aa4cc/flying-ball-in-hoop/model/text/model_text.pdf

## Ball in double hoop: Derivation of a mathematical model

Martin Gurtner

1. MODELING

The system is cartooned in Fig. 1 and the modes of the hybrid description are displayed in Fig. 2. The hybrid description has three modes: the ball rolls on the outer hoop (S1), the ball is in free fall (S2), and the ball rolls on the inner hoop (S3).

Before we delve into the derivation of equations of motion for each mode, let us devote a few words to coordinate systems in which we will describe the motion of the ball. Due to the rotational symmetry, polar coordinates are a natural choice for modes S1 and S3. In contrast, Cartesian coordinates are more suitable for the free-fall mode (S2) because then the equations of motion are linear. In fact, it turns out that the description of motion in S2 in polar coordinates is strongly nonlinear. Thus, from the implementation point of view (i.e. to increase numerical stability), one should use polar coordinates for modes S1 and S3 and Cartesian coordinates for S2. Nevertheless, transformations of the coordinates would make equations in this paper unnecessarily complicated, and thus we stick to polar coordinates for all three modes.

For simplicity, we will not state the time dependence explicitly. At first, we derive equations of motion for each mode and after that, we describe guards and reset maps for transitions between the modes.

1.1 Outer hoop (S1)

A model of a ball rolling in a hoop was derived by ?. For reader’s convenience—and because Wellstead made a small mistake in the derivation of the model—we rederive the model.

We use Euler-Lagrange equation to derive the model. Let us choose angles ψ and θ (see Fig. 1) as the generalized co-

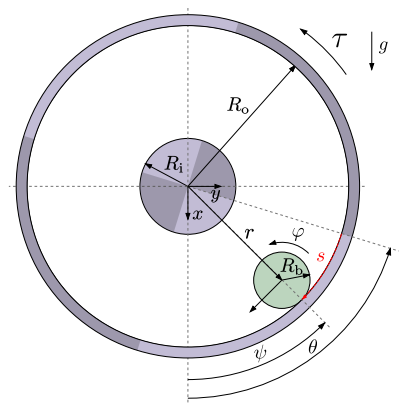
[picture p7: figure]

Fig. 1. A sketch of the ball and hoop system.

ordinates. We assume that the ball rolls without slipping. In addition, we assume that we can directly command the torque τ acting on the hoop.

The kinetic co-energy of the ball is

T

∗ =

1
2

mv² +

1
2

Ib( ˙ϕ + ˙θ)
2 +

1
2

Ih

˙θ
2
, | (1)

where m is the mass of the ball, Ib is the moment of inertia of the ball, Ih is the moment of inertia of the hoop and ϕ =

s
Rb

=

Ro
Rb

(θ − ψ). The translational velocity v and the angular velocity ˙ϕ of the ball can be expressed as follows
v = − (Ro − Rb) ψ,˙ | (2a)

ϕ˙ =

Ro
Rb
˙θ − ψ˙
. | (2b)

Thus, the kinetic energy expressed in the generalized coordinates is

T

∗ =

1
2

m (Ro − Rb)

2
ψ˙²+

1
2

Ib

Ro + Rb
Rb

˙θ −

Ro
Rb

ψ˙

2
| +
| 1
| 2 Ih

˙θ
2
(3)
Potential energy of the system is given by the potential energy of the ball and that is by
V = −mg (Ro − Rb) cos ψ | (4)

and the system content modeling friction of the ball and hoop is

D =

1
2

bbϕ˙

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
˙θ − ψ˙

2
+

1
2

bh

˙θ
2
. (5)

Defining the Lagrangian L = T

∗ − V , an equations of
motion of the hoop and the ball, respectively, can be computed by Euler-Lagrange equation as
d
dt
∂L
∂ ˙θ
−

∂L
∂θ +

∂D
∂ ˙θ
= τ | (6)

d
dt
∂L
∂ψ˙
−

∂L
∂ψ +

∂D
∂ψ˙
= 0 | (7)

which results in the following differential equation a¯oψ¨ + ¯boψ˙ + ¯co sin ψ + ¯do

˙θ = ¯eo

¨θ, | (8)

with coefficients

Outer hoop | Free fall | Inner hoop
S1 | S2 | S3

γ1 > 0

γ2 > 0

γ3 > 0

γ4 > 0

Fig. 2. Modes of the hybrid description of the ball and hoop system.

Fig. 3. A sketch of the ball rolling on the inner hoop.

a¯o = m (Ro − Rb)

2 + I

R²
o
R²
b
, | (9a)

¯bo = b

R²
o
R²
b
, | (9b)
c¯o = mg (Ro − Rb), | (9c)
¯do = −¯bo, | (9d)

e¯o = I

Ro
Rb
Ro
Rb

+ 1
. | (9e)

1.2 Free fall (S2)

The motion of the center of the ball in free fall can be easily described in Cartesian coordinates because the only force acting on the ball is the gravitational force. Considering the Cartesian coordinate system shown in Fig. 1, we have

x¨ = g | and | ¨y = 0. | (10)

In order to get equations of motion in polar coordinates (r, ψ) (see Fig. 1), we only need to transform the coordinates by relations x = r cos ψ and y = r sin ψ. This way, we get

r¨ = rψ˙² + g cos ψ, | (11a)

ψ¨ = −

1
r
g sin ψ + 2ψ˙r˙
| | . | (11b)

To fully describe the state of the system during free fall of the ball we also need to describe evolution of ϕ; we assume that the angular velocity ˙ϕ is constant during the free fall.

1.3 Inner hoop (S3)

A sketch of the ball rolling on the inner hoop is shown in Fig. 3. The equations of motion for the ball rolling on the inner hoop can be derived along similar lines as for the ball on the outer hoop. The only difference is that the effective rolling radius is Ri + Rb instead of Ro − Rb and angle ϕ has the opposite orientation. Therefore, we skip the derivation and state directly the resulting equations of motion:
a¯iψ¨ + ¯biψ˙ + ¯ci sin ψ + ¯di

˙θ = ¯ei

¨θ, | (12)

where

a¯i = m (Ri + Rb)

2 + I

R²
i
R²
b
, | (13a)

¯bi = b

R²
i
R²
b
, | (13b)
c¯i = mg (Ri + Rb), | (13c)
¯di = −¯bi
, | (13d)

e¯i = I

Ri
Rb
Ri
Rb

− 1

. | (13e)

1.4 Transition between modes

Transition from S1 to S2 Mode S1 (outer hoop) is valid as long as the centripetal force Fc acting on the ball is larger then the normal component of the gravitational force Fg with respect to the hoop. Mathematically, it is valid if
Fg cos ψ + Fc = mg cos ψ + m (Ro − Rb) ψ˙² > 0. (14)

If this condition does not hold, the ball drops of the hoop. It readily follows from (14) that the guard for transition from S1 to S2 is
γ1 = −g cos ψ − (Ro − Rb) ψ˙² > 0. | (15)

The reset map for states r, ˙r, ϕ and ˙ϕ is r

+ = Ro − Rb, | (16a)

r˙

+ = 0, | (16b)

ϕ

+ = (θ

− − ψ

−)

Ro
Rb
, | (16c)

ϕ˙

+ =

Ro + Rb
Rb

˙θ −

Ro
Rb
ψ.˙ | (16d)

The first three relations are apparent. The last one is derived from the inertial angular velocity ( ˙ϕ

− + ˙θ
−) of the
ball and (2b). The remaining states transit to the mode S2 without any change, that is θ

+ = θ

−,

˙θ

+ = ˙θ
−, ψ
+ = ψ

−
and ψ˙+ = ψ˙−.

Transition from S2 to S1 This transition occurs when the ball hits the outer hoop. Thus the guard is
γ2 = r − Ro + Rb > 0 | (17)
and the corresponding reset map for ψ˙
is
ψ˙⁺ = ψ˙⁻ + ψ˙⁻
rot | (18)
where ψ˙⁻
rot is derived from the angular velocity of the ball ϕ˙

− and can be computed from (2b):

ψ˙⁻
rot = ˙θ
− −

Rb
Ro

ϕ˙

−. | (19)

The remaining states transit unchanged, that is θ

+ = θ

−,
˙θ

+ = ˙θ
− and ψ
+ = ψ

−.

Transition from S2 to S3 Analogously to the previous case, the transit occurs when the ball hits the inner hoop and the guard is
γ3 = Ri + Rb − r > 0. | (20)
The reset map is also almost the same; the only difference is that the angular velocity ψ˙⁻
rot here is computed as follows

ψ˙⁻

rot = ˙θ
− +

Rb
Ri

ϕ˙

−. | (21)

Transition from S3 to S2 Similarly to the transition from the outer hoop to free fall, the transition from the inner hoop to free fall occurs when the centripetal force becomes larger then the normal component of the gravitational force with respect to the hoop, that is
γ4 = g cos ψ + (Ri + Rb) ψ˙² > 0.

and analogously to (16), the reset map is
r
+ = Ri + Rb, | (22a)

r˙

+ = 0, | (22b)

ϕ

+ = −(θ

− − ψ

−)

Ri
Rb
, | (22c)

ϕ˙

+ = −

Ri − Rb
Rb

˙θ −

Ri
Rb

ψ˙

, | (22d)

with the remaining states θ,

˙θ, ψ and ψ˙ transiting unchanged.

min
u(t),x(t),Tf

# Z Tf

0

u

2
(t)dt | (23)

subject to: x(0) = x0
x(Tf) = xf
0 < Tf < Tmax
g (x(t)) < 0
|u(t)| ≤ umax
x˙(t) = f(x(t), u(t))

x

∗

(t), u∗
(t) (24)

A(t) = ∂f (x(t), u(t))
∂x
x(t)=x∗(t),u(t)=u∗(t)

(25)

B(t) = ∂f (x(t), u(t))
∂u
x(t)=x∗(t),u(t)=u∗(t)

(26)

δx = x − x

∗
, δu = u − u

∗
