aa4cc/flying-ball-in-hoop/model/text/figs/asd.pdf

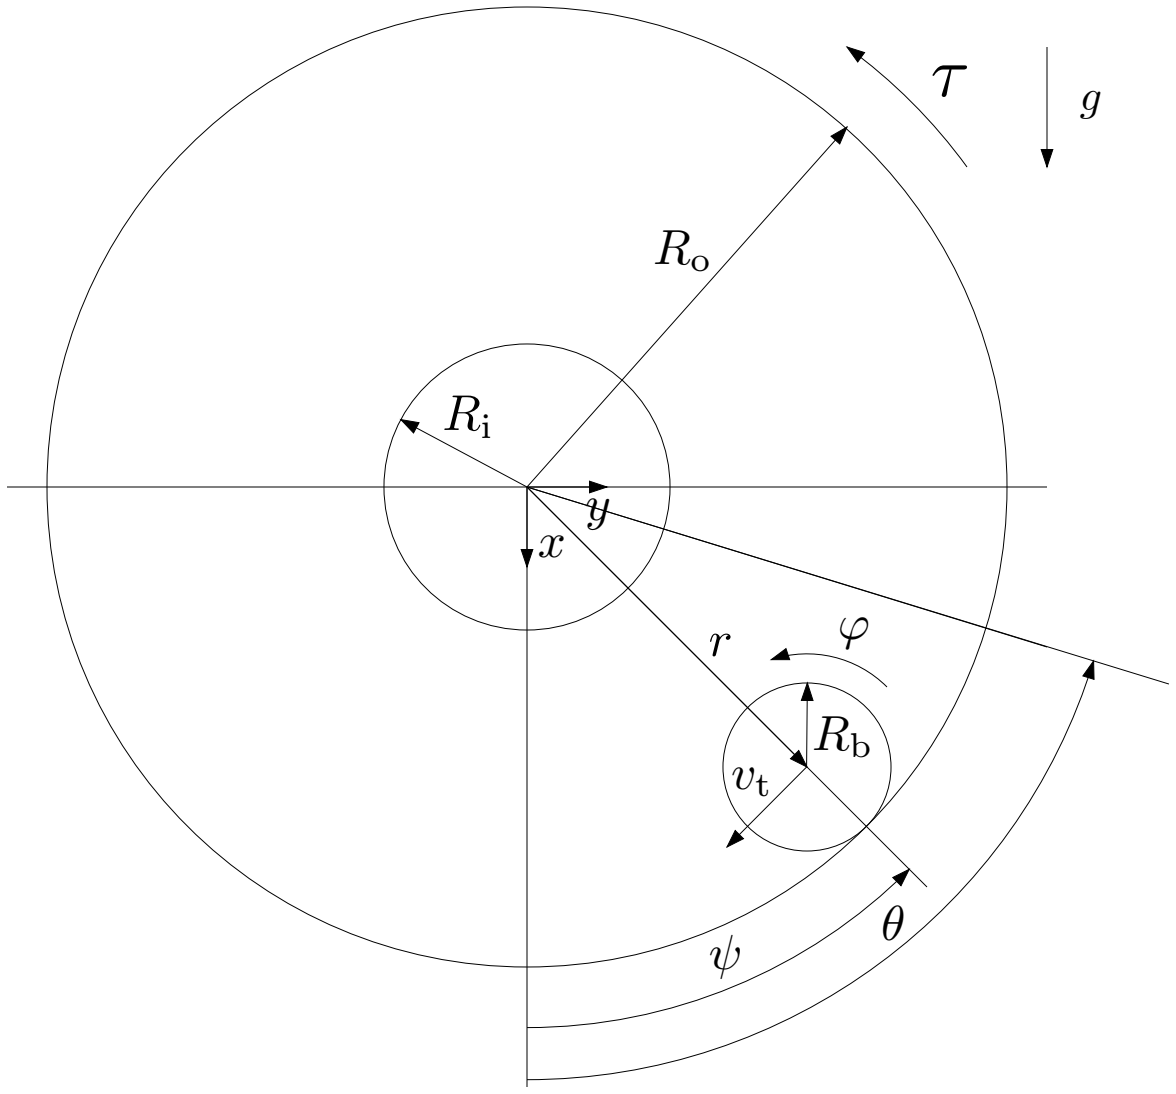
[picture p8: figure]
