aa4cc/flying-ball-in-hoop/cad/hoop/dimensionDescription.jpg

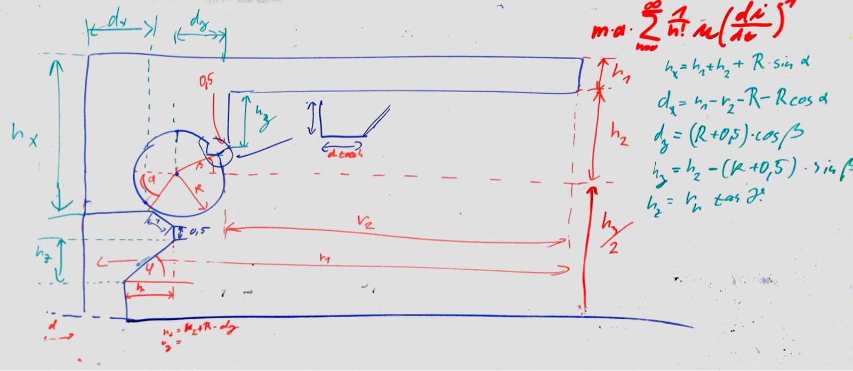
cad/hoop/dimensionDescription.jpg
