aa4cc/flying-ball-in-hoop/docs/img/BoxBack.jpg

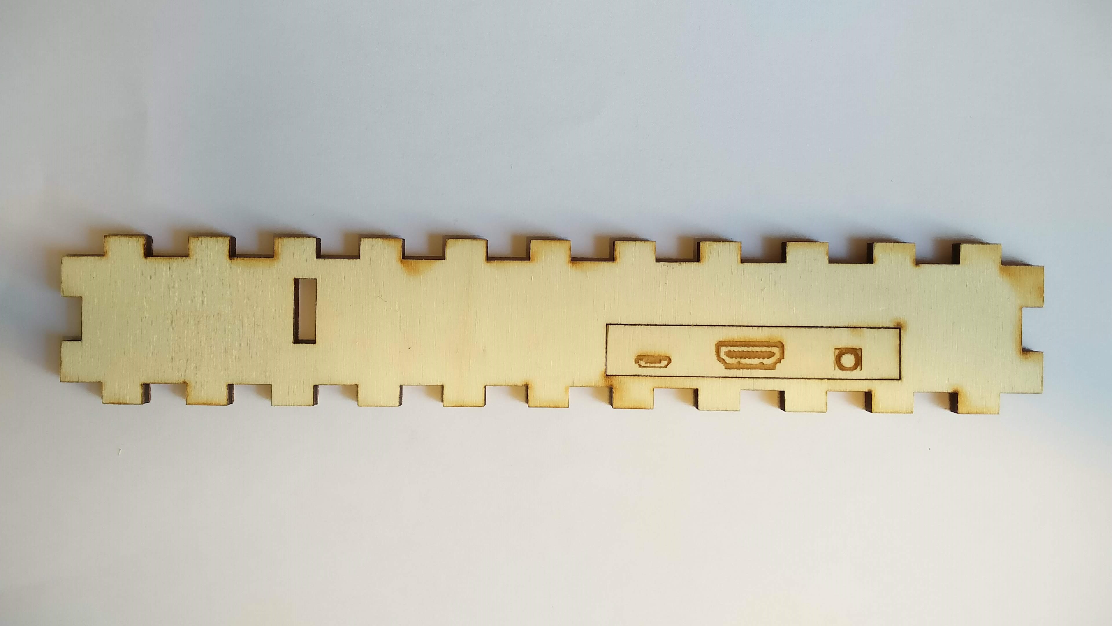
docs/img/BoxBack.jpg
