aa4cc/flying-ball-in-hoop/docs/img/BoxClosedHolder.jpg

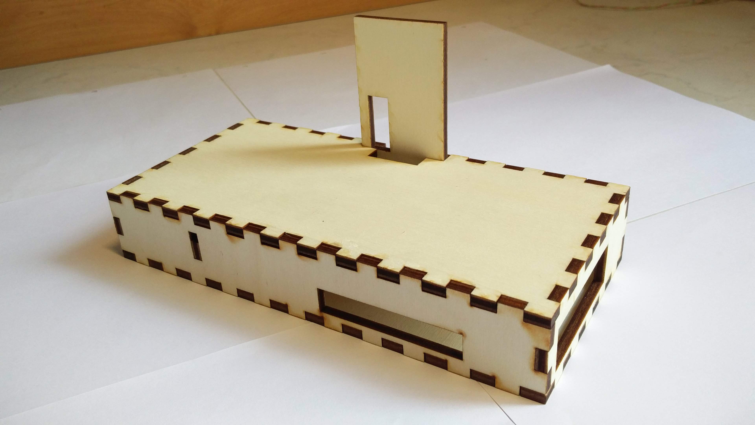
docs/img/BoxClosedHolder.jpg
