aa4cc/flying-ball-in-hoop/docs/img/BoxFront1.jpg

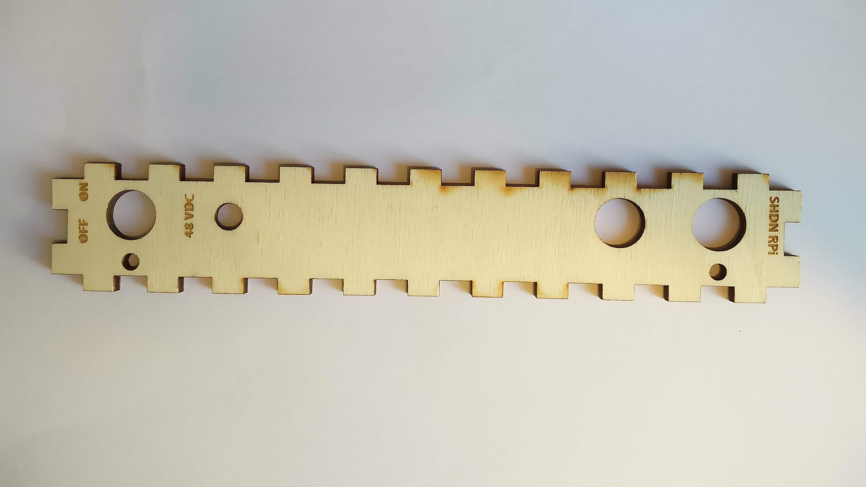
docs/img/BoxFront1.jpg
