aa4cc/flying-ball-in-hoop/docs/img/BoxOpenHolder.jpg

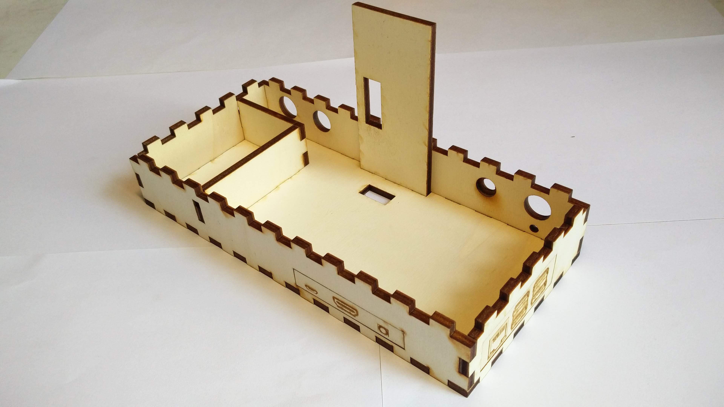
docs/img/BoxOpenHolder.jpg
