aa4cc/flying-ball-in-hoop/m/identification/Copy_of_exp03_prbs/led.png

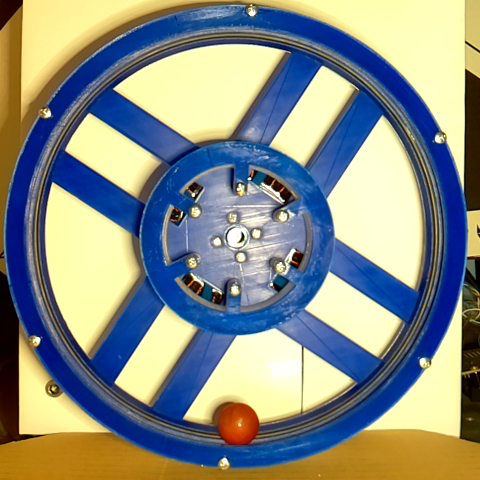
m/identification/Copy_of_exp03_prbs/led.png
