aa4cc/flying-ball-in-hoop/m/identification/Copy_of_exp03_prbs/meas_pos01.png

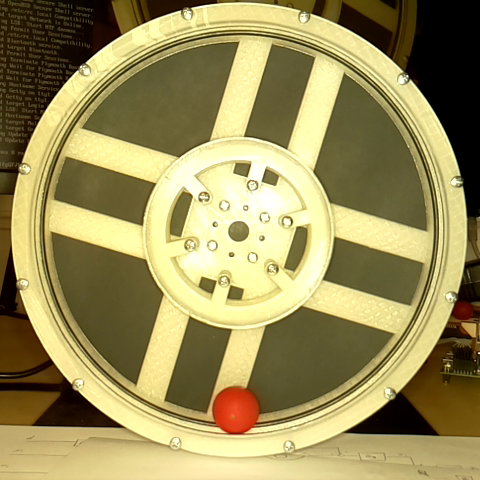
m/identification/Copy_of_exp03_prbs/meas_pos01.png
