aa4cc/flying-ball-in-hoop/m/identification/exp01/meas_pos01.png

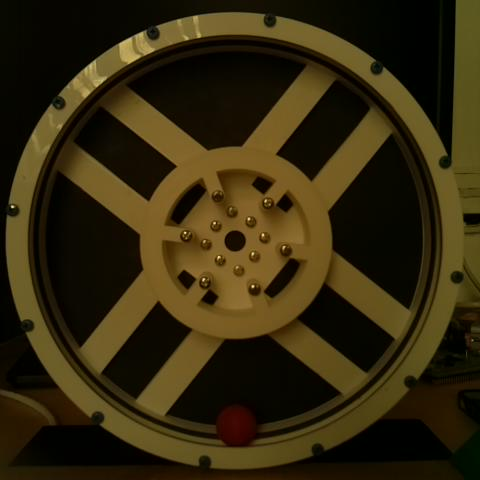
m/identification/exp01/meas_pos01.png
