aa4cc/flying-ball-in-hoop/m/identification/exp02_prbs/meas_pos01.png

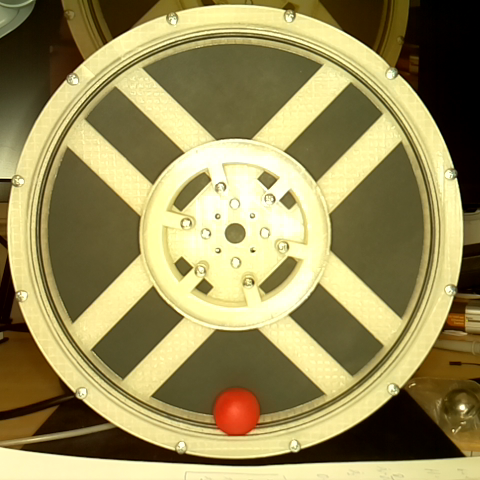
m/identification/exp02_prbs/meas_pos01.png
