aa4cc/flying-ball-in-hoop/docs/img/LaserCutter/Front2.dxf

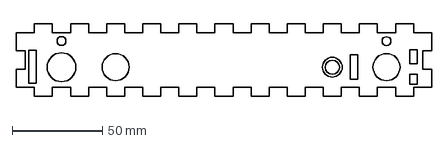
[picture p18: CAD file, 2019-02-22]
docs/img/LaserCutter/Front2.dxf
230.0 x 40.0 mm
