aa4cc/flying-ball-in-hoop/docs/img/LaserCutter/Front.dxf

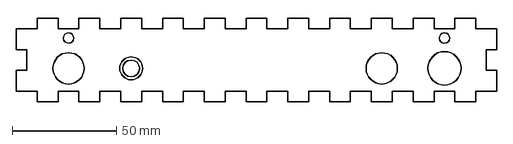
[picture p19: CAD file, 2019-02-22]
docs/img/LaserCutter/Front.dxf
230.0 x 40.0 mm
