aa4cc/flying-ball-in-hoop/docs/img/LaserCutter/Holder.dxf

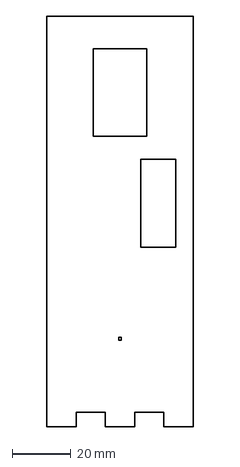
[picture p20: CAD file, 2019-02-22]
docs/img/LaserCutter/Holder.dxf
50.0 x 140.0 mm
