aa4cc/flying-ball-in-hoop/docs/img/LaserCutter/Inner2.dxf

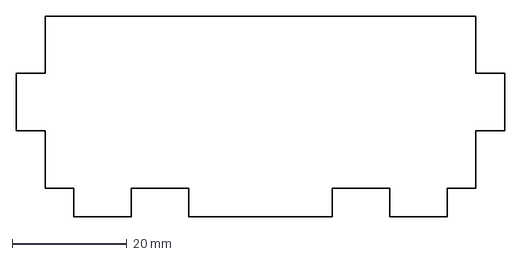
[picture p21: CAD file, 2019-02-22]
docs/img/LaserCutter/Inner2.dxf
85.0 x 35.0 mm
