aa4cc/flying-ball-in-hoop/docs/img/LaserCutter/Top2.dxf

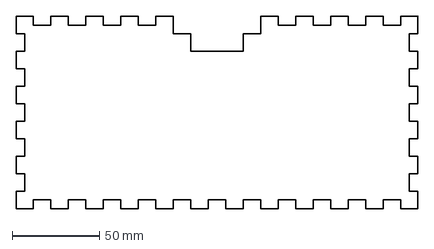
[picture p22: CAD file, 2019-02-22]
docs/img/LaserCutter/Top2.dxf
230.0 x 110.0 mm
