aa4cc/flying-ball-in-hoop/docs/img/LaserCutter/Back.dxf

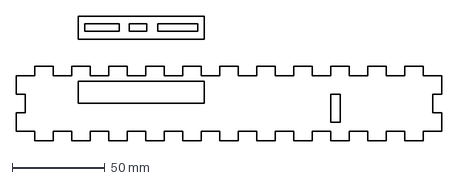
[picture p23: CAD file, 2019-02-22]
docs/img/LaserCutter/Back.dxf
230.0 x 67.0 mm
