aa4cc/flying-ball-in-hoop/docs/img/LaserCutter/Inner1.dxf

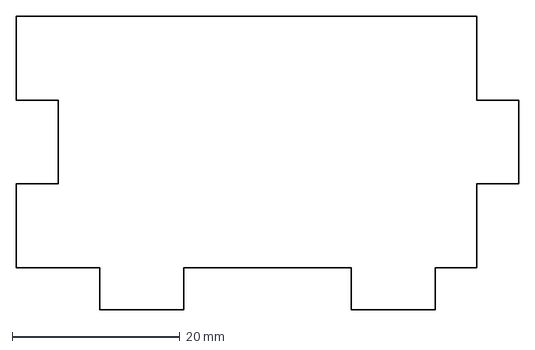
[picture p24: CAD file, 2019-02-22]
docs/img/LaserCutter/Inner1.dxf
60.0 x 35.0 mm
