aa4cc/flying-ball-in-hoop/docs/img/LaserCutter/Bot.dxf

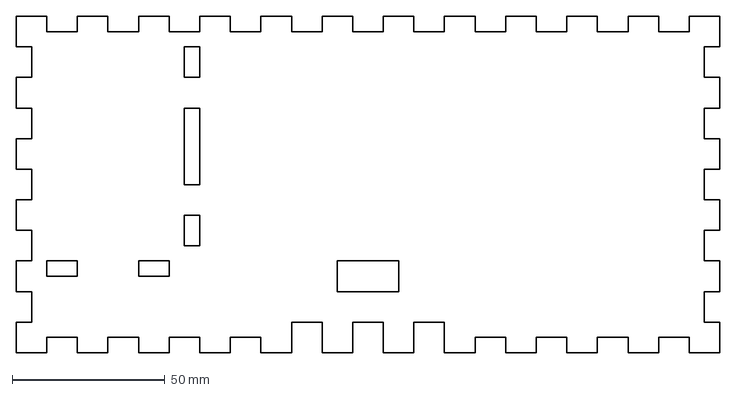
[picture p25: CAD file, 2019-02-22]
docs/img/LaserCutter/Bot.dxf
230.0 x 110.0 mm
