aa4cc/flying-ball-in-hoop/docs/img/LaserCutter/RightSide.dxf

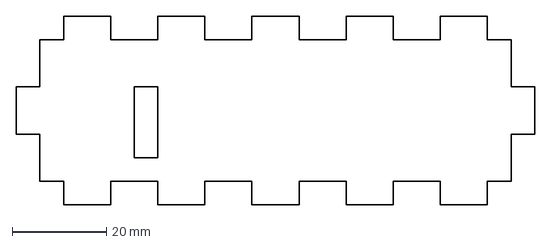
[picture p26: CAD file, 2019-02-22]
docs/img/LaserCutter/RightSide.dxf
110.0 x 40.0 mm
