aa4cc/flying-ball-in-hoop/docs/img/LaserCutter/LeftSide.dxf

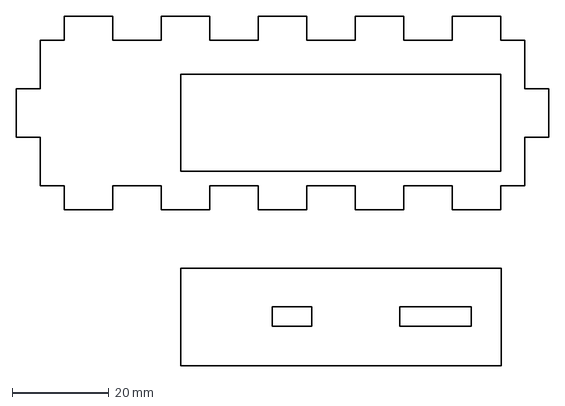
[picture p27: CAD file, 2019-02-22]
docs/img/LaserCutter/LeftSide.dxf
110.0 x 72.2 mm
