aa4cc/flying-ball-in-hoop/docs/img/LaserCutter/backBlackSheet.dxf

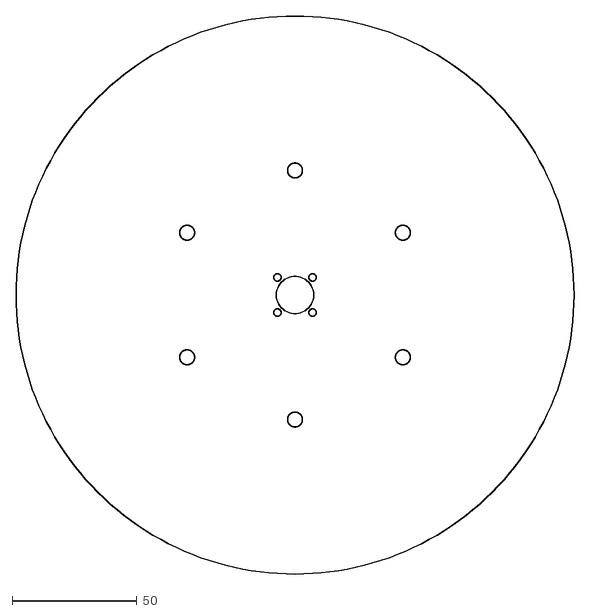
[picture p28: CAD file, 2018-10-05]
docs/img/LaserCutter/backBlackSheet.dxf
224.0 x 224.0
