aa4cc/flying-ball-in-hoop/(list of files, cad)

Other CAD files:
cad/lampHeatSink/lampHeatSink.dwg
cad/raspiHolder/raspiHolder.dwg
cad/lampHeatSink/light_diffuser.dwg
cad/hoop/data-access.scad
cad/hoop/data-metric_cyl_head_bolts.scad
cad/hoop/materials.scad
