aa4cc/flying-ball-in-hoop/docs/buildingInstructions_HW.md

---
layout: page
title: Hardware assembly
subtitle: A step-by-step photoguide
---
<!--
# Ball in Hoop

## Introduction -->

The assembly guide is divided into several steps. At first, we will make the light, then we will make the box. Then we will attach it to the acrylics. Successively, we print the motor holder and the hoop in 3D printer, mount the holder to the board, attach the motor, encoder and ODrive to the holder and finally mount the hoop to the motor. Then we will wire all things together and move to the software.

# 1. Light

Please visit <https://github.com/aa4cc/raspicam-lamp>

We actually realized that we are not satisfied with the concept of the light (see _Future development_) and decided to solder several things differently from what we previously intended. Details are provided in the next picture:

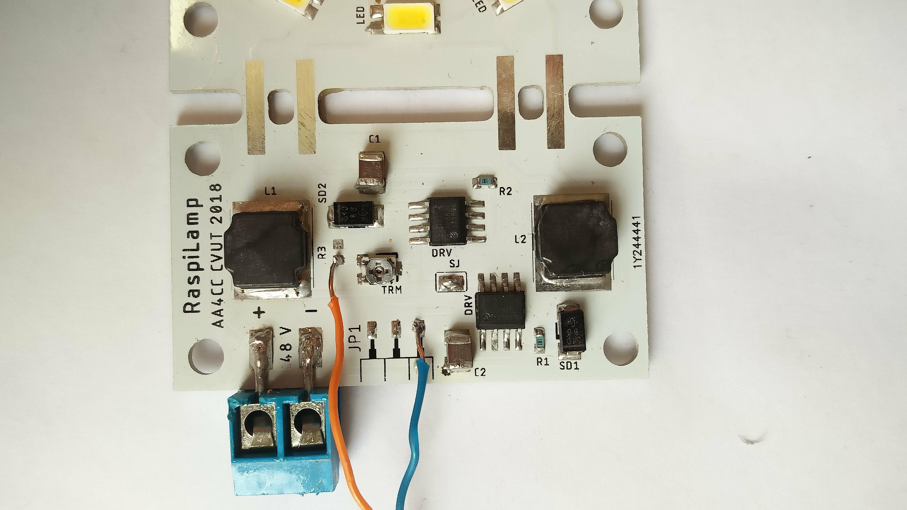
[picture p29: docs/img/LightCtrl.jpg]
LightCtrl


This means that we used the trimmer to lessen the voltage coming from RPi (3.3V) to a voltage convenient for the AP8801 chip (cca 1.25V) and we control both LED branches simultaneously, because solder jumper is soldered.

# 2. Box

Box is glued together according to following pictures:

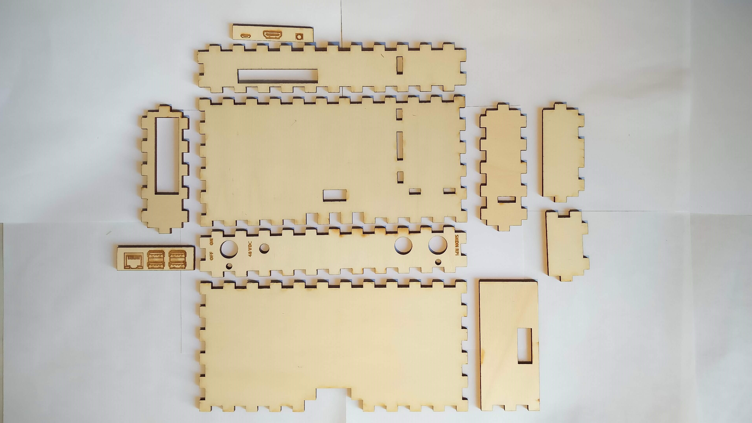
[picture p30: docs/img/BoxInPlane.jpg]
BoxInPlane


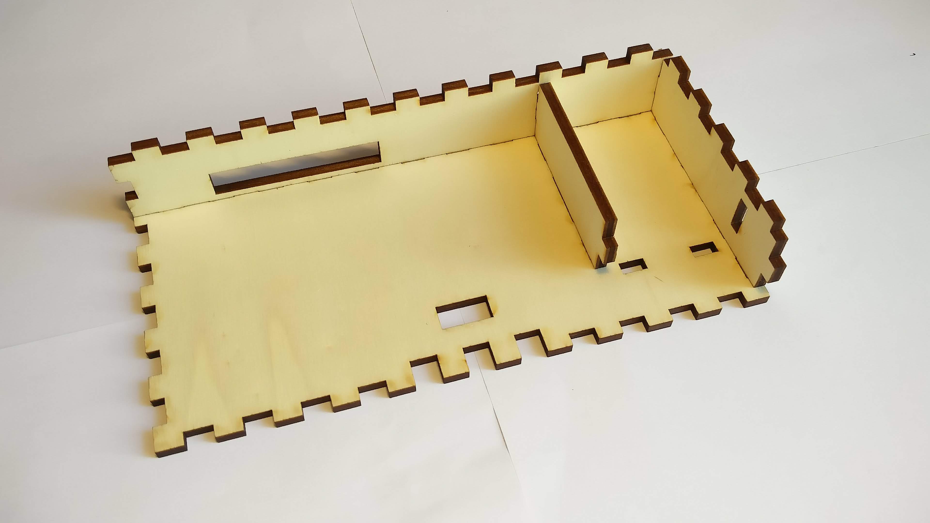
[picture p31: docs/img/BoxHalfBuilt.jpg]
BoxHalfBuilt


Inner walls in the box are not glued in order to be easily removed in case of need. You can put the inner walls into the box thanks to enlarged holes in the back and the right side of the box:

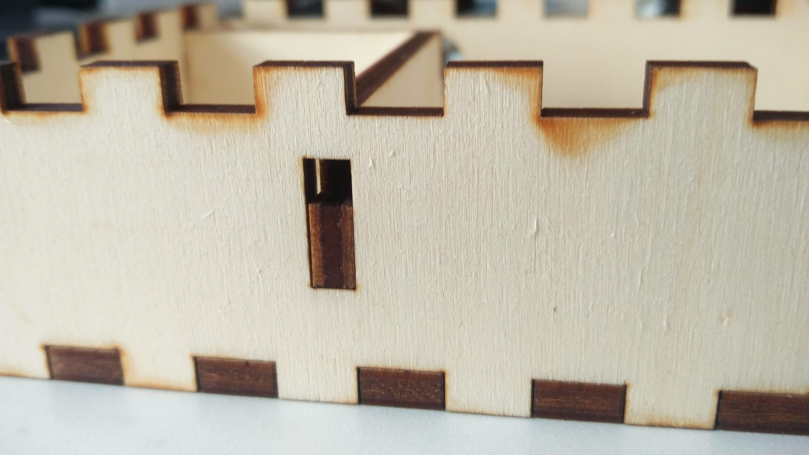
[picture p32: docs/img/BoxInnerDetail.jpg]
BoxInnerDetail


# 3. Acrylic

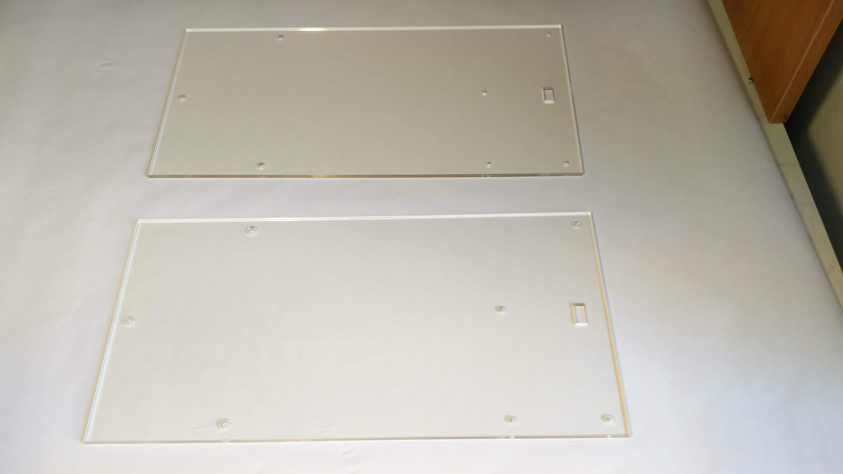
[picture p33: docs/img/Acrylics.jpg]
Acrylics


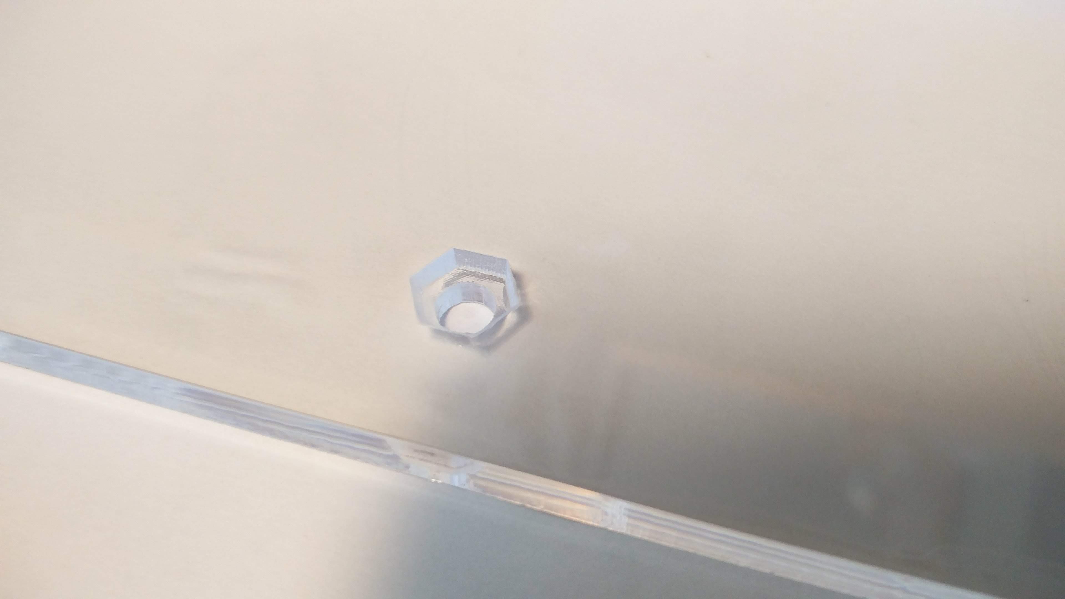
[picture p34: docs/img/AcrylicEngraved.jpg]
AcrylicEngraved


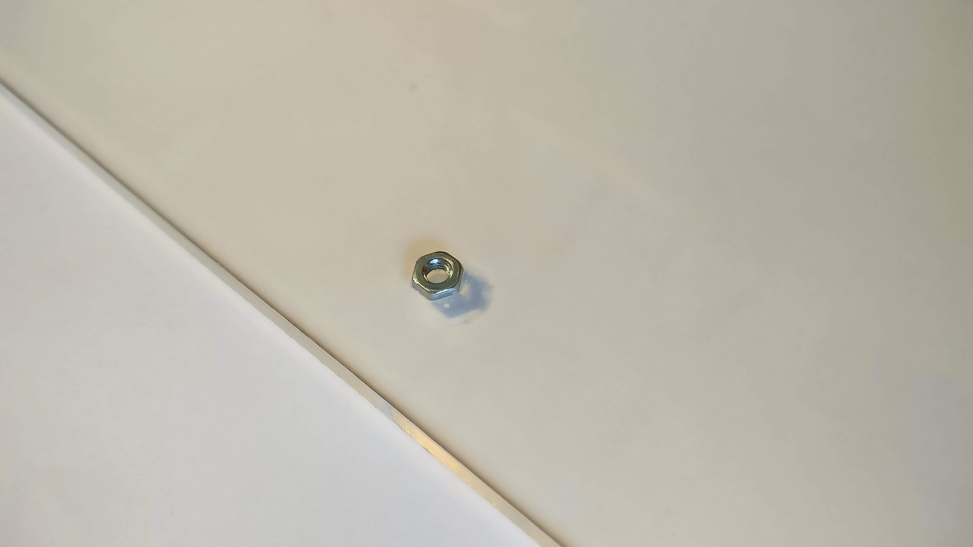
[picture p35: docs/img/AcrylicEngravedNut.jpg]
AcrylicEngravedNut


We put the not-engraved acrylic on the engraved one, place the box on the top and mount everything together with screws.

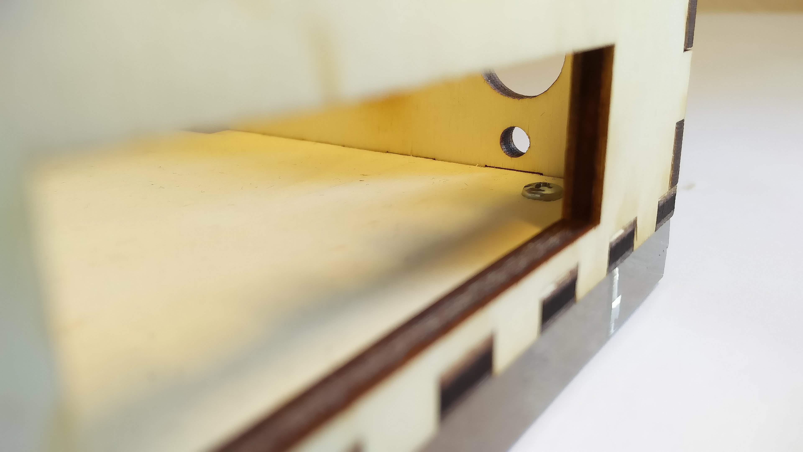
[picture p36: docs/img/BoxMounted.jpg]
BoxMounted


# 4. Motor holder

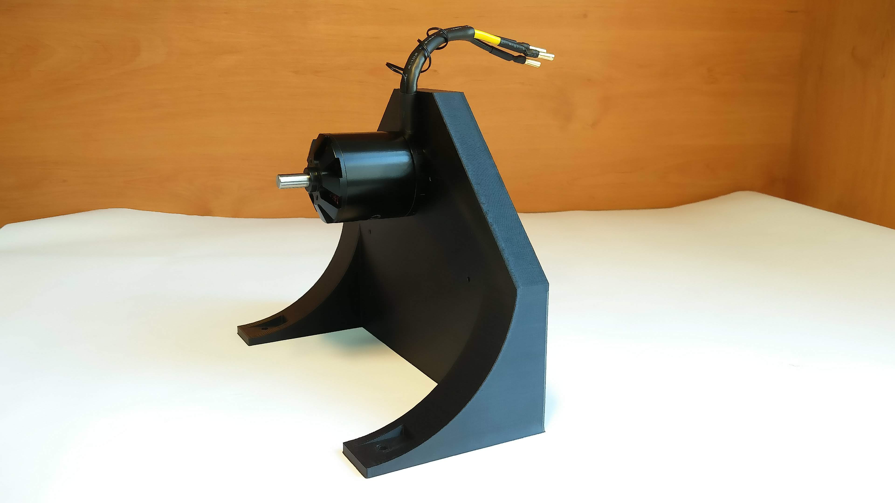
[picture p37: docs/img/HolderMotor.jpg]
HolderMotor


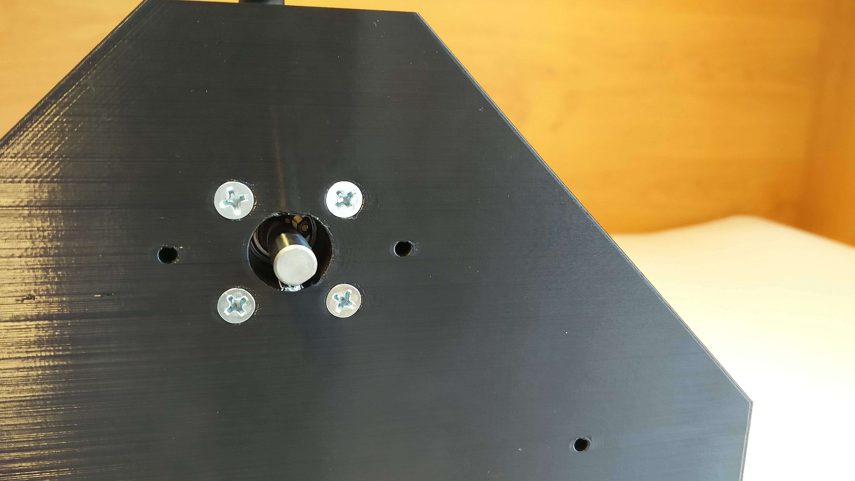
[picture p38: docs/img/HolderMotorScrews.jpg]
HolderMotorScrews


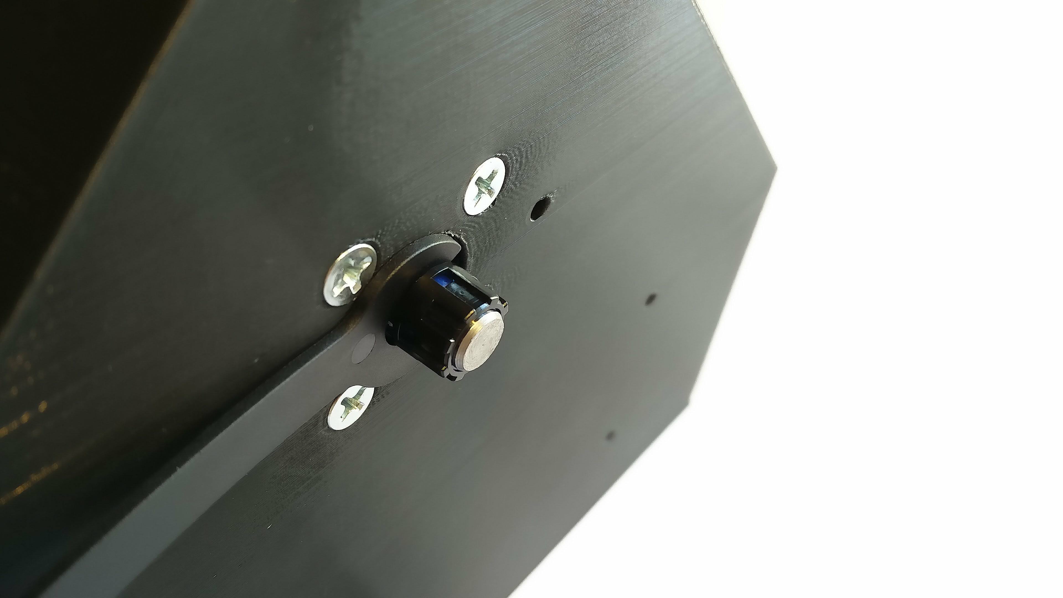
[picture p39: docs/img/HolderEncoderAttaching.jpg]
HolderEncoderAttaching


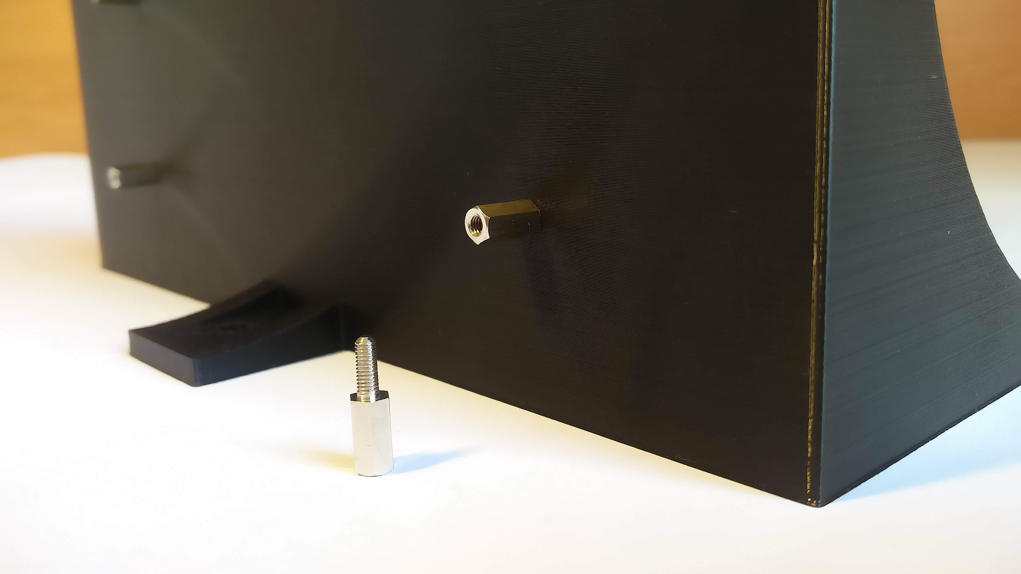
[picture p40: docs/img/HolderSpacer.jpg]
HolderSpacer


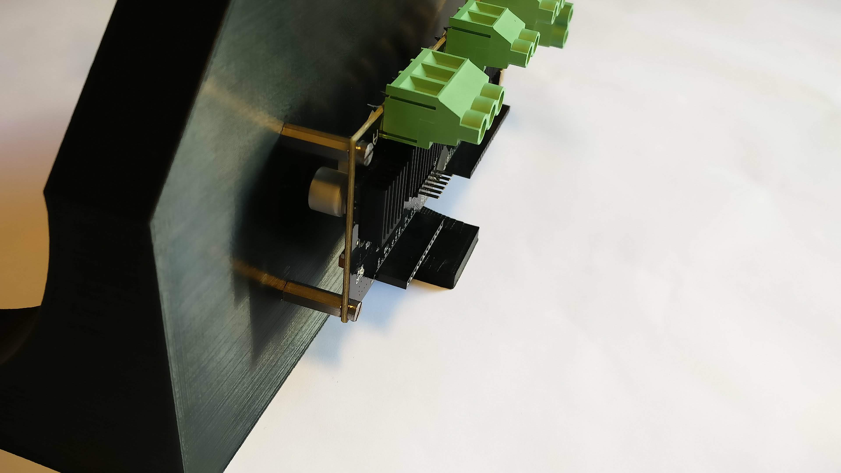
[picture p41: docs/img/HolderODrive.jpg]
HolderODrive


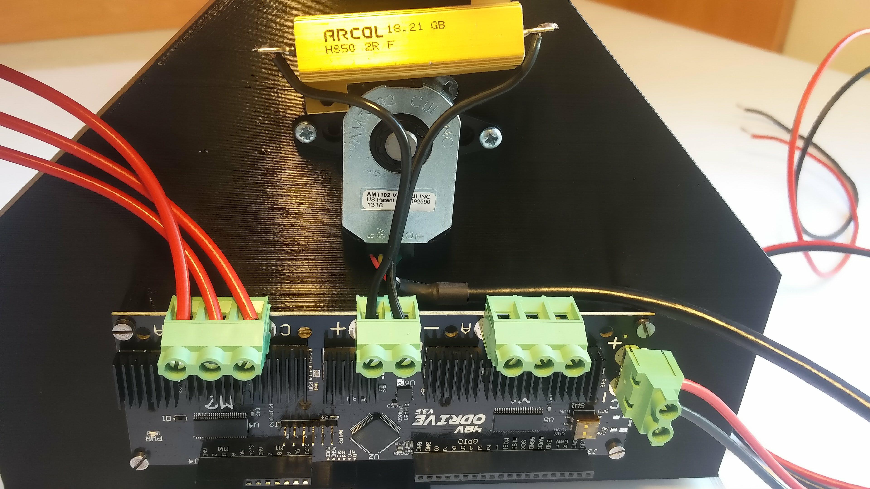
[picture p42: docs/img/HolderBack.jpg]
HolderBack


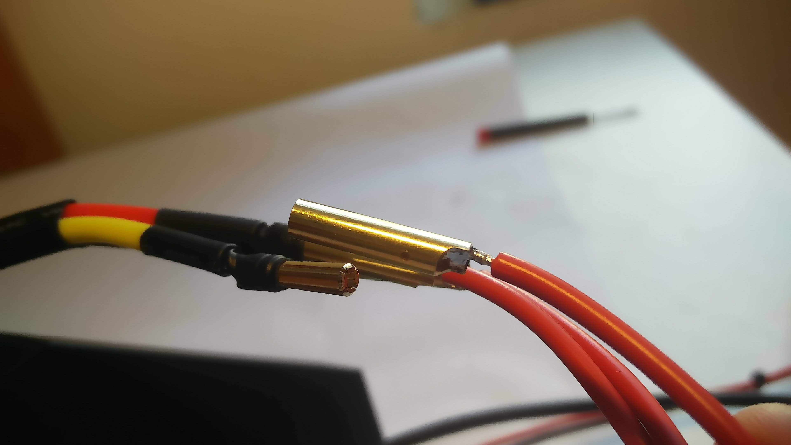
[picture p43: docs/img/WiringDetail.jpg]
WiringDetail


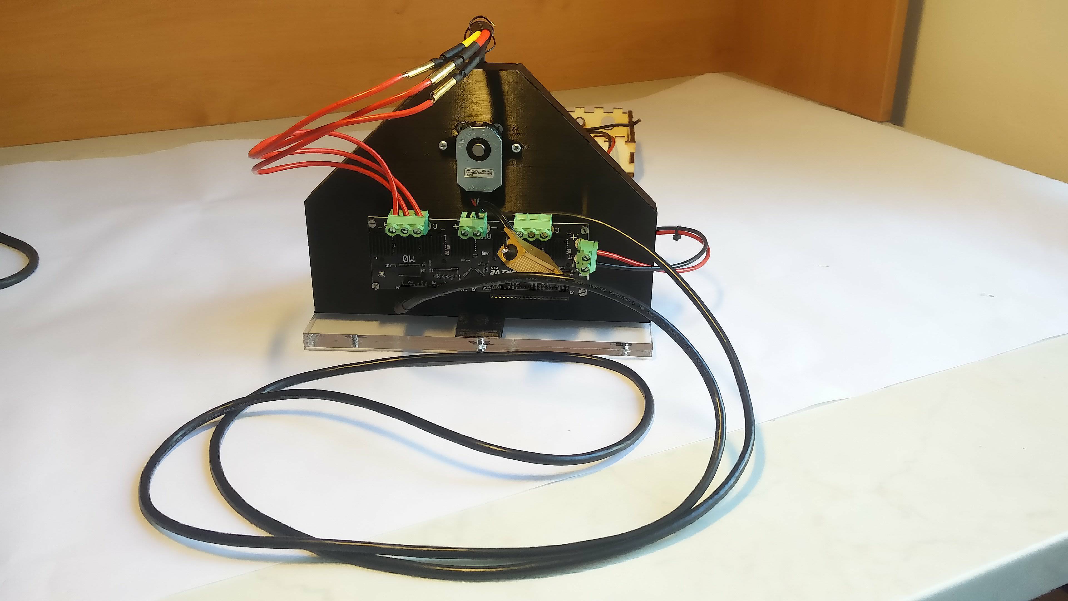
[picture p44: docs/img/HolderBack2.jpg]
HolderBack2


After that, we attach the holder to the acrylic.

# 5. Hoop

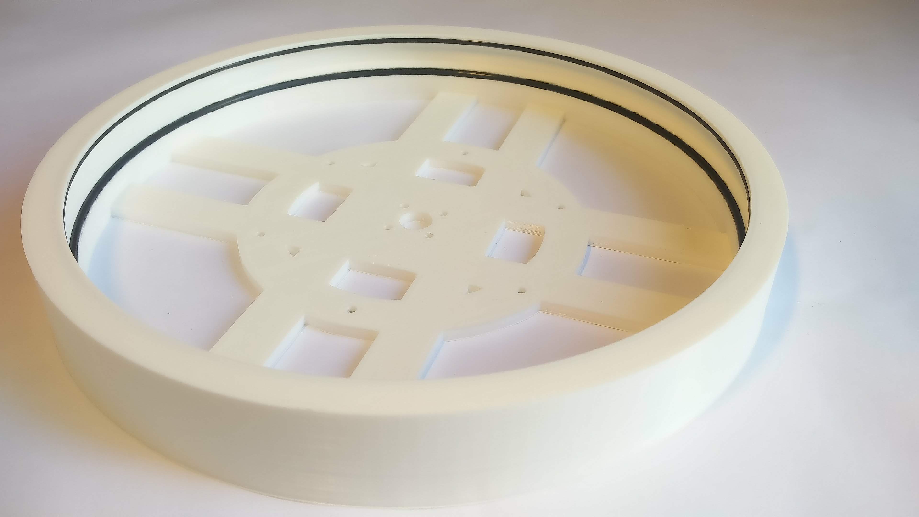
[picture p45: docs/img/Hoop.jpg]
Hoop


The o-rings must be thoroughly pressed into the hoop otherwise they will cause bouncing of the ball. We recommend to use screw washers while mounting the hoop to the motor.

# 6. Electronics and wiring

We mount the RasPi into the box using plywood spacers (we had screws that were too long, so we gave the spacer also above the RasPi).

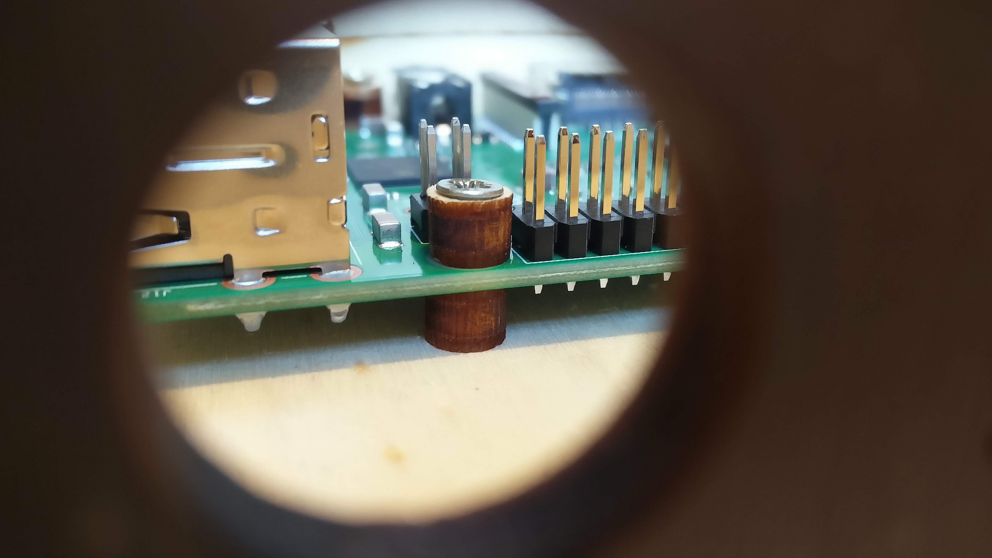
[picture p46: docs/img/RPiMount.jpg]
RPiMount


We put the connectors into the front side of the box, solder the wires to them and cover the connections with a heat shrink tubing. We use Wago Lever Nuts when need to branch the wires.

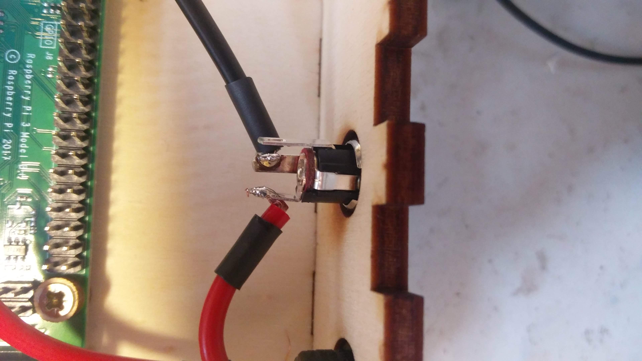
[picture p47: docs/img/WiringSolder.jpg]
WiringSolder


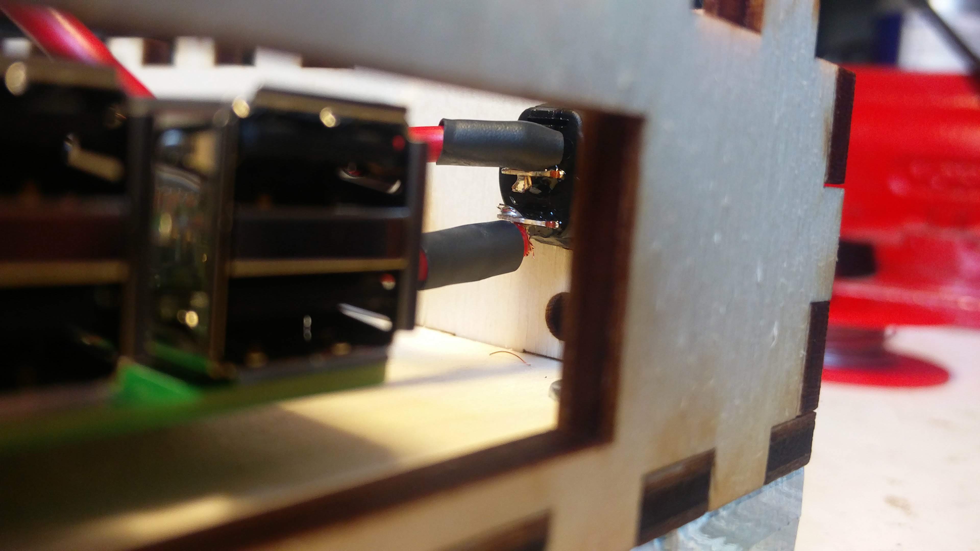
[picture p48: docs/img/WiringSolder2.jpg]
WiringSolder2


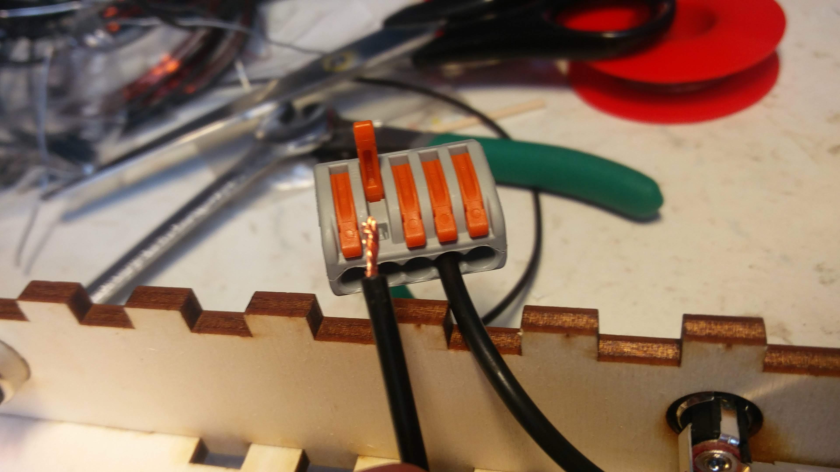
[picture p49: docs/img/WiringWago.jpg]
WiringWago


(Wiring picture to be added)

# Future development

1. To lessen the RasPi PWM signal from 3.3V to 1.25V directly on the light module.

2. To make the camera mounting holes tighter and to cut a screw thread in them so that no nuts were needed.

3. To redesign the power and PWM connectors on the light module in a smarter way.

4. To use a motor with a shorter shaft which would not overhang into the hoop.
