aa4cc/flying-ball-in-hoop/docs/img/WiringPerspective.jpg

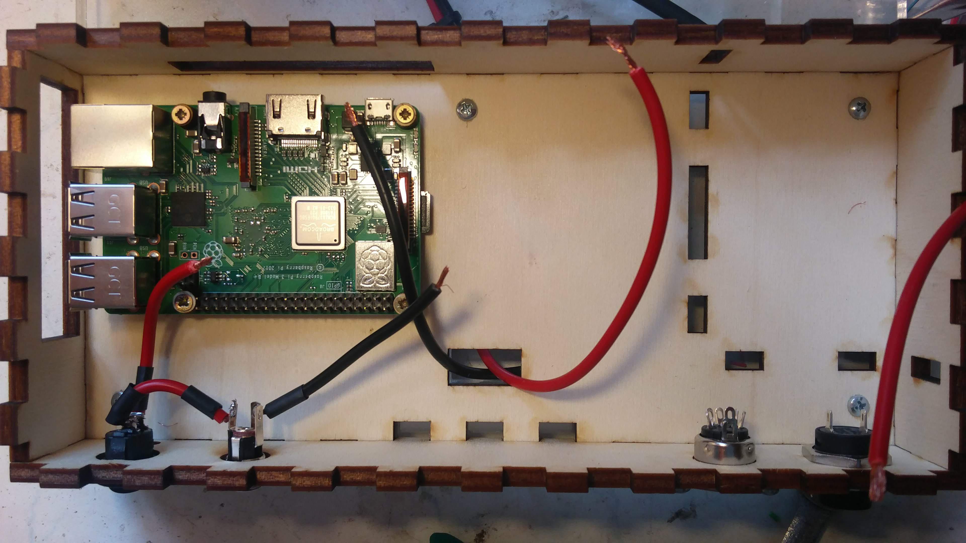
docs/img/WiringPerspective.jpg
