aa4cc/flying-ball-in-hoop/model/text/figs/inner.pdf

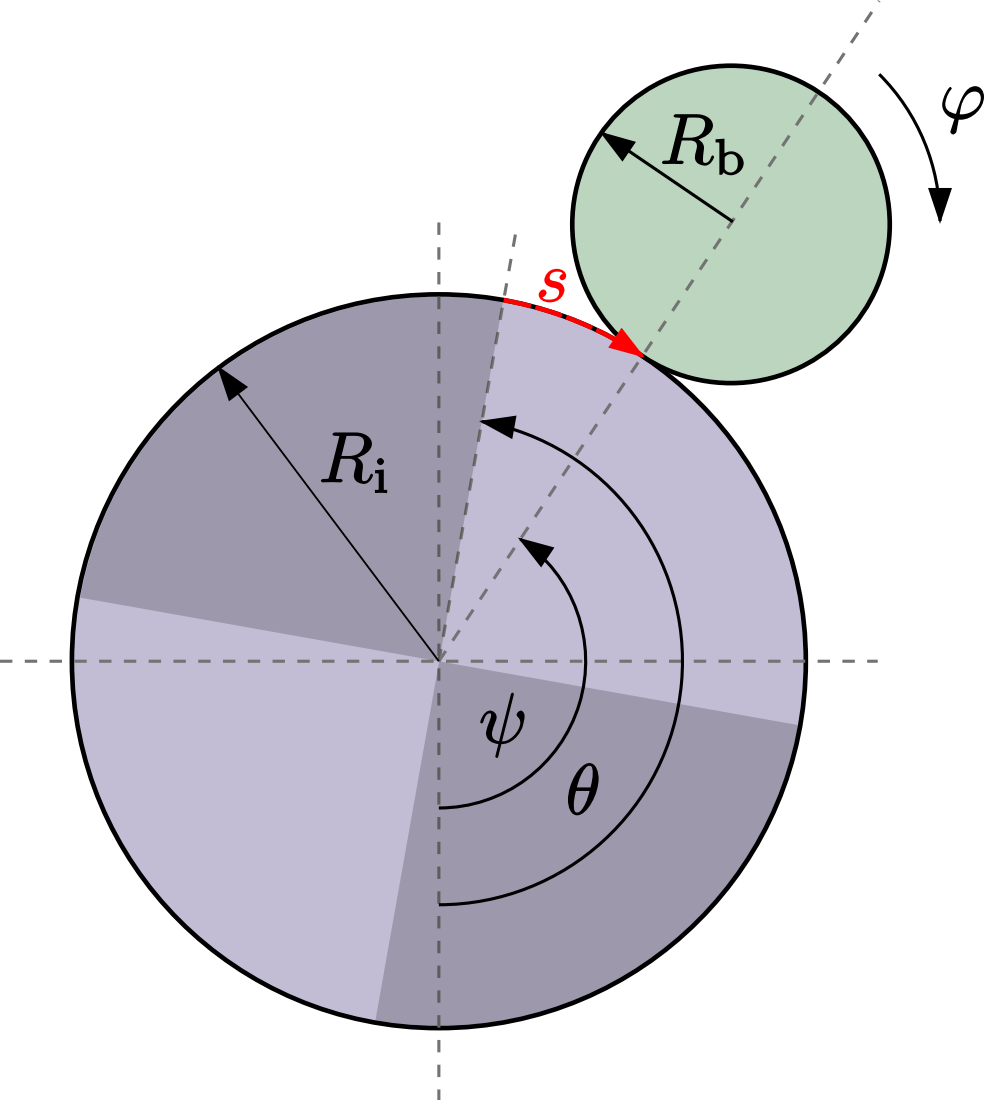
[picture p51: page 1]
