aa4cc/flying-ball-in-hoop/model/text/figs/sketchOfBallInAHoop.pdf

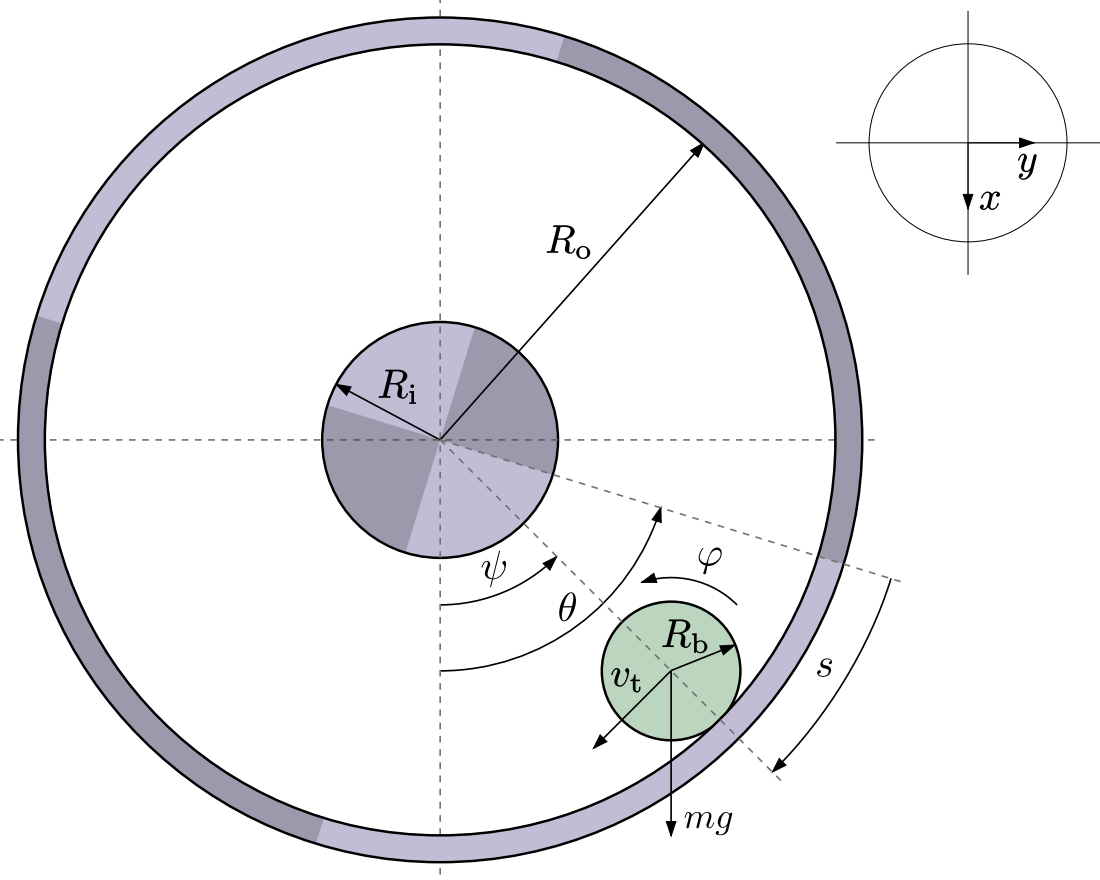
[picture p52: page 1]
