aa4cc/flying-ball-in-hoop/model/text/figs/sketchOfBallInAHoop2.pdf

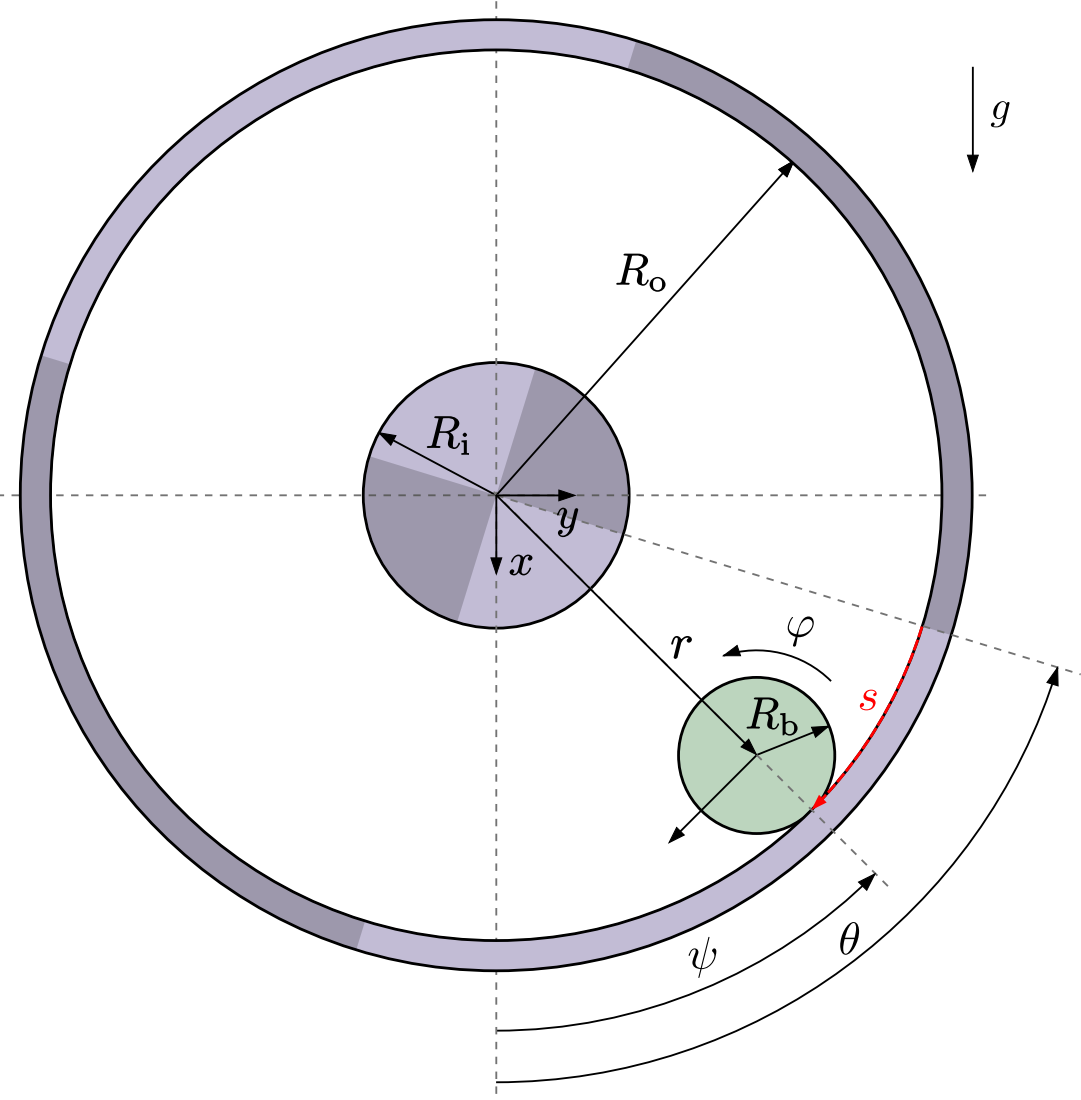
[picture p53: page 1]
