aa4cc/flying-ball-in-hoop/model/text/figs/sketchOfBallInAHoop3-eps-converted-to.pdf

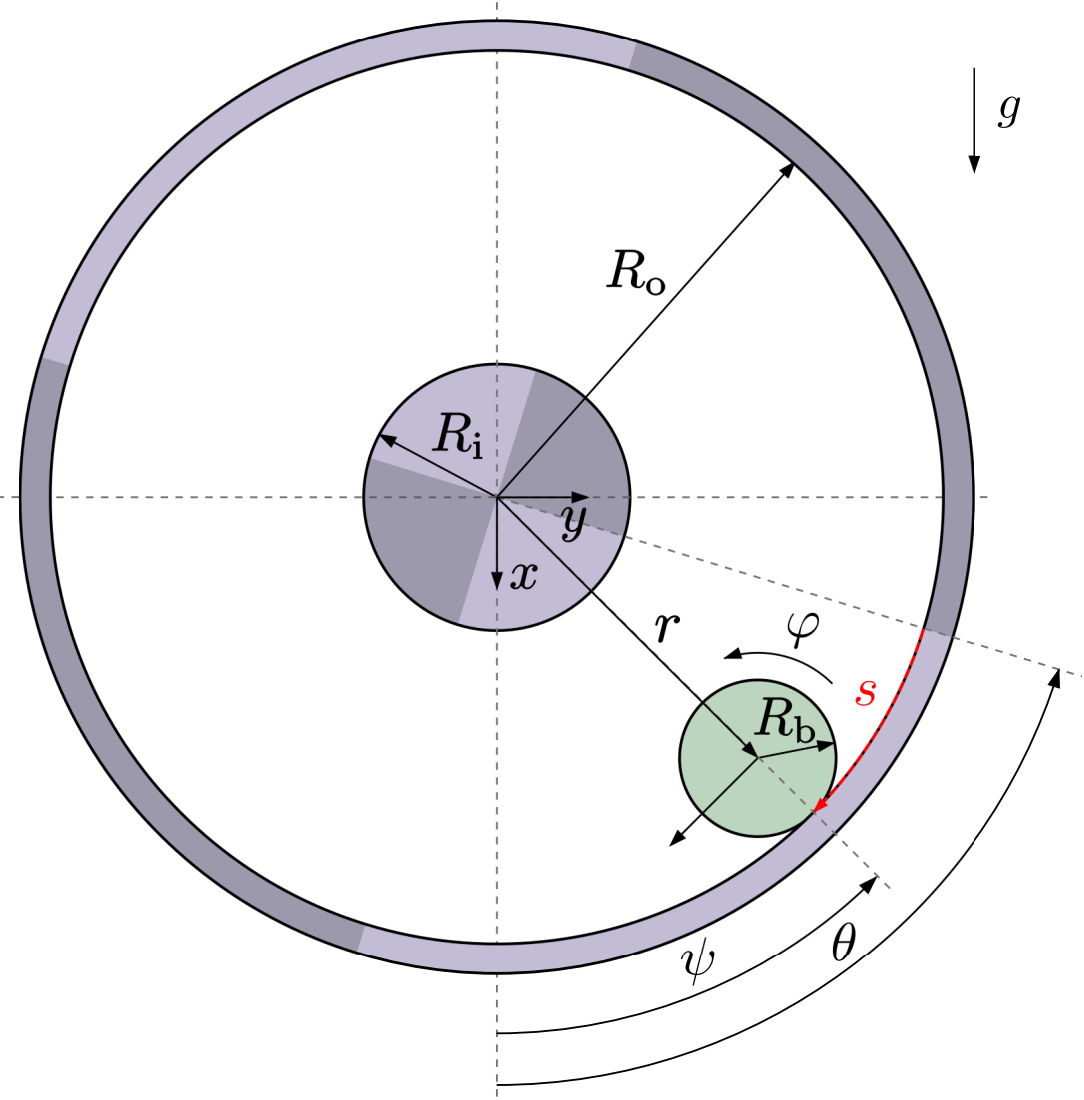
[picture p54: page 1]
