aa4cc/flying-ball-in-hoop/model/text/figs/sketchOfBallInAHoop3.pdf

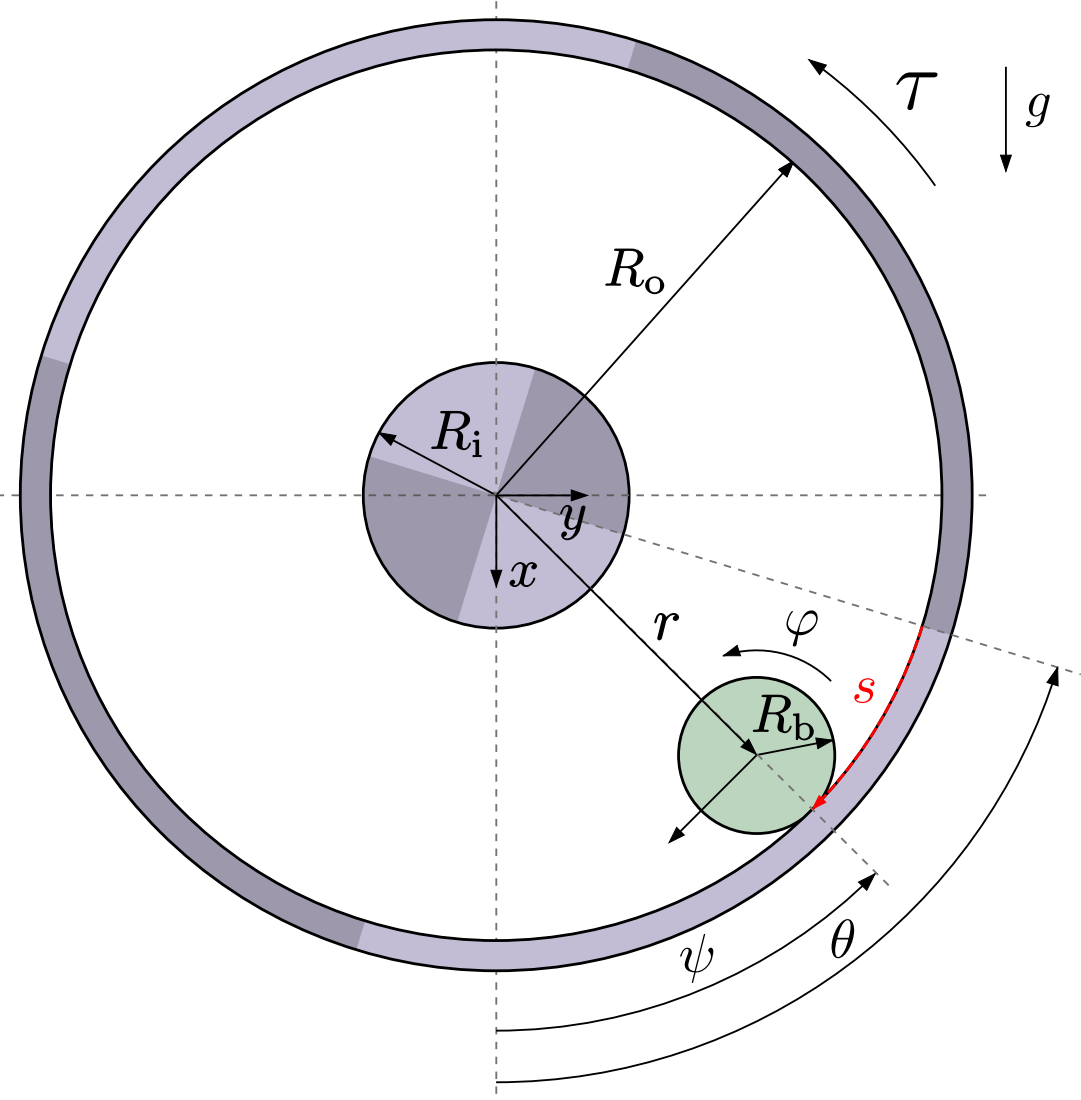
[picture p55: page 1]
