aa4cc/flying-ball-in-hoop/scripts/shutdown.py

#!/usr/bin/python
import RPi.GPIO as GPIO
import time
import subprocess

GPIO.setmode(GPIO.BOARD)

# we will use the pin numbering to match the pins on the Pi, instead of the
# GPIO pin outs (makes it easier to keep track of things)
# use the same pin that is used for the reset button (one button to rule them all!)
GPIO.setup(37, GPIO.IN, pull_up_down=GPIO.PUD_UP)

# Switch on the power LED
led = 19
GPIO.setup(led, GPIO.OUT)
GPIO.output(led, 1)

oldButtonState1 = True

while True:
    #grab the current button state
    buttonState1 = GPIO.input(37)

    # check to see if button has been pushed
    if buttonState1 != oldButtonState1 and buttonState1 == False:
        # shutdown
        subprocess.Popen(['poweroff'])
        # Switch off the power LED
        GPIO.output(led, 0)
        oldButtonState1 = buttonState1
        break

    time.sleep(.5)
