aa4cc/flying-ball-in-hoop/(commit log)

2018-09-27 Shutdown button service added
2018-09-27 Web template added
    [controller_board.brd, controller_board.sch, motorHolder.scad, sensor_board_ma700.brd, sensor_board_ma700.sch]
2018-10-05 black backsheet added
    [backBlackSheet.dxf, hoopInOnePiece.scad]
2018-10-15 power-off script modified so that it lits up the power LED
2019-01-02 raspiballpos updated
    [hoop.scad, hoopInOnePiece.scad]
2019-02-22 Laser Cutter
    [Back.dxf, Bot.dxf, Front.dxf, Front2.dxf, Holder.dxf, Inner1.dxf, Inner2.dxf, LeftSide.dxf]
